valerium-labs/L2P/SCHEMATIC/cuts.png

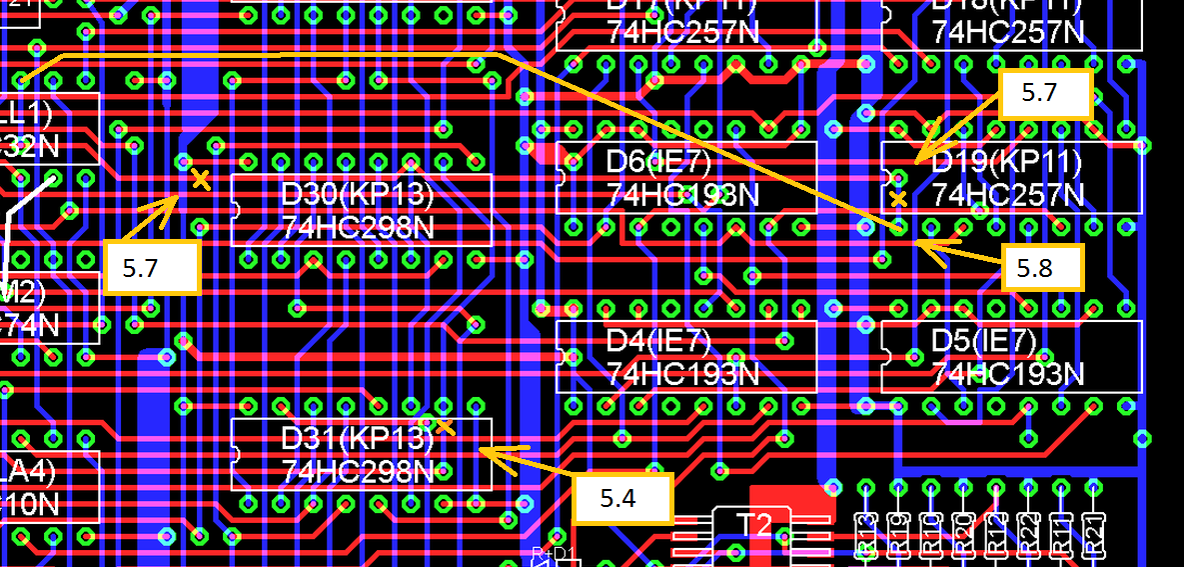
SCHEMATIC/cuts.png
