valerium-labs/L2P/CPLD/L2P_description.txt

A compilation of hardware mods to convert Leningrad-1 Speccy clone screen timings to Pentagon timings (see SCHEMATIC folder)
