valerium-labs/L2P/CPLD/l2p.png

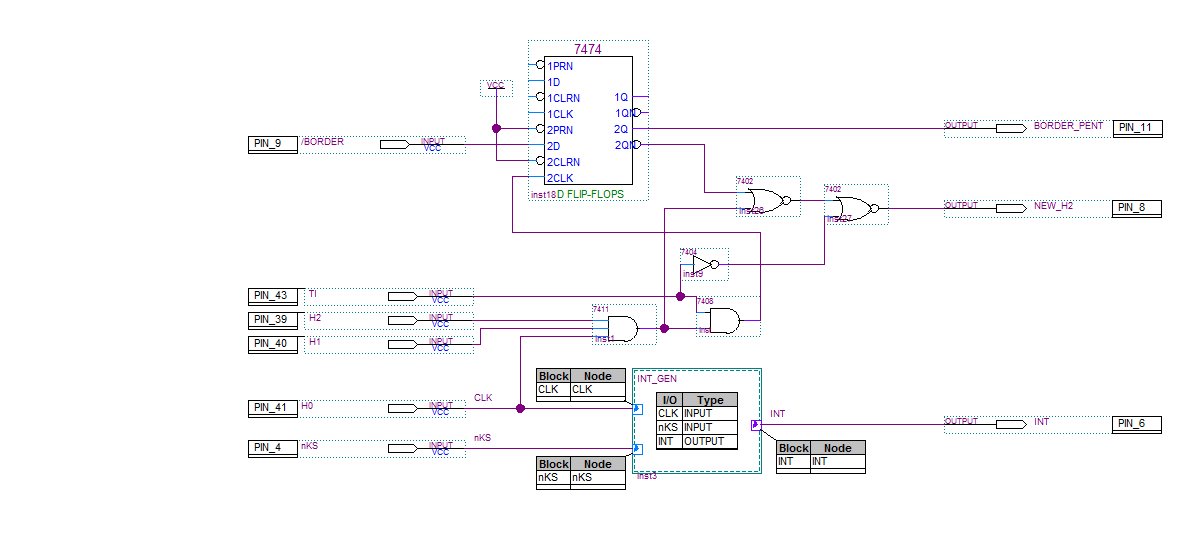
CPLD/l2p.png
